thomasnisole/ESP32-Evo-Remote-Pilot-NMEA2000/KiCAD/ESP32EvoPilotRemote/ESP32EvoPilotRemote.kicad_pcb

## KiCad design KiCAD/ESP32EvoPilotRemote/ESP32EvoPilotRemote.kicad_pcb (2023-03-05)

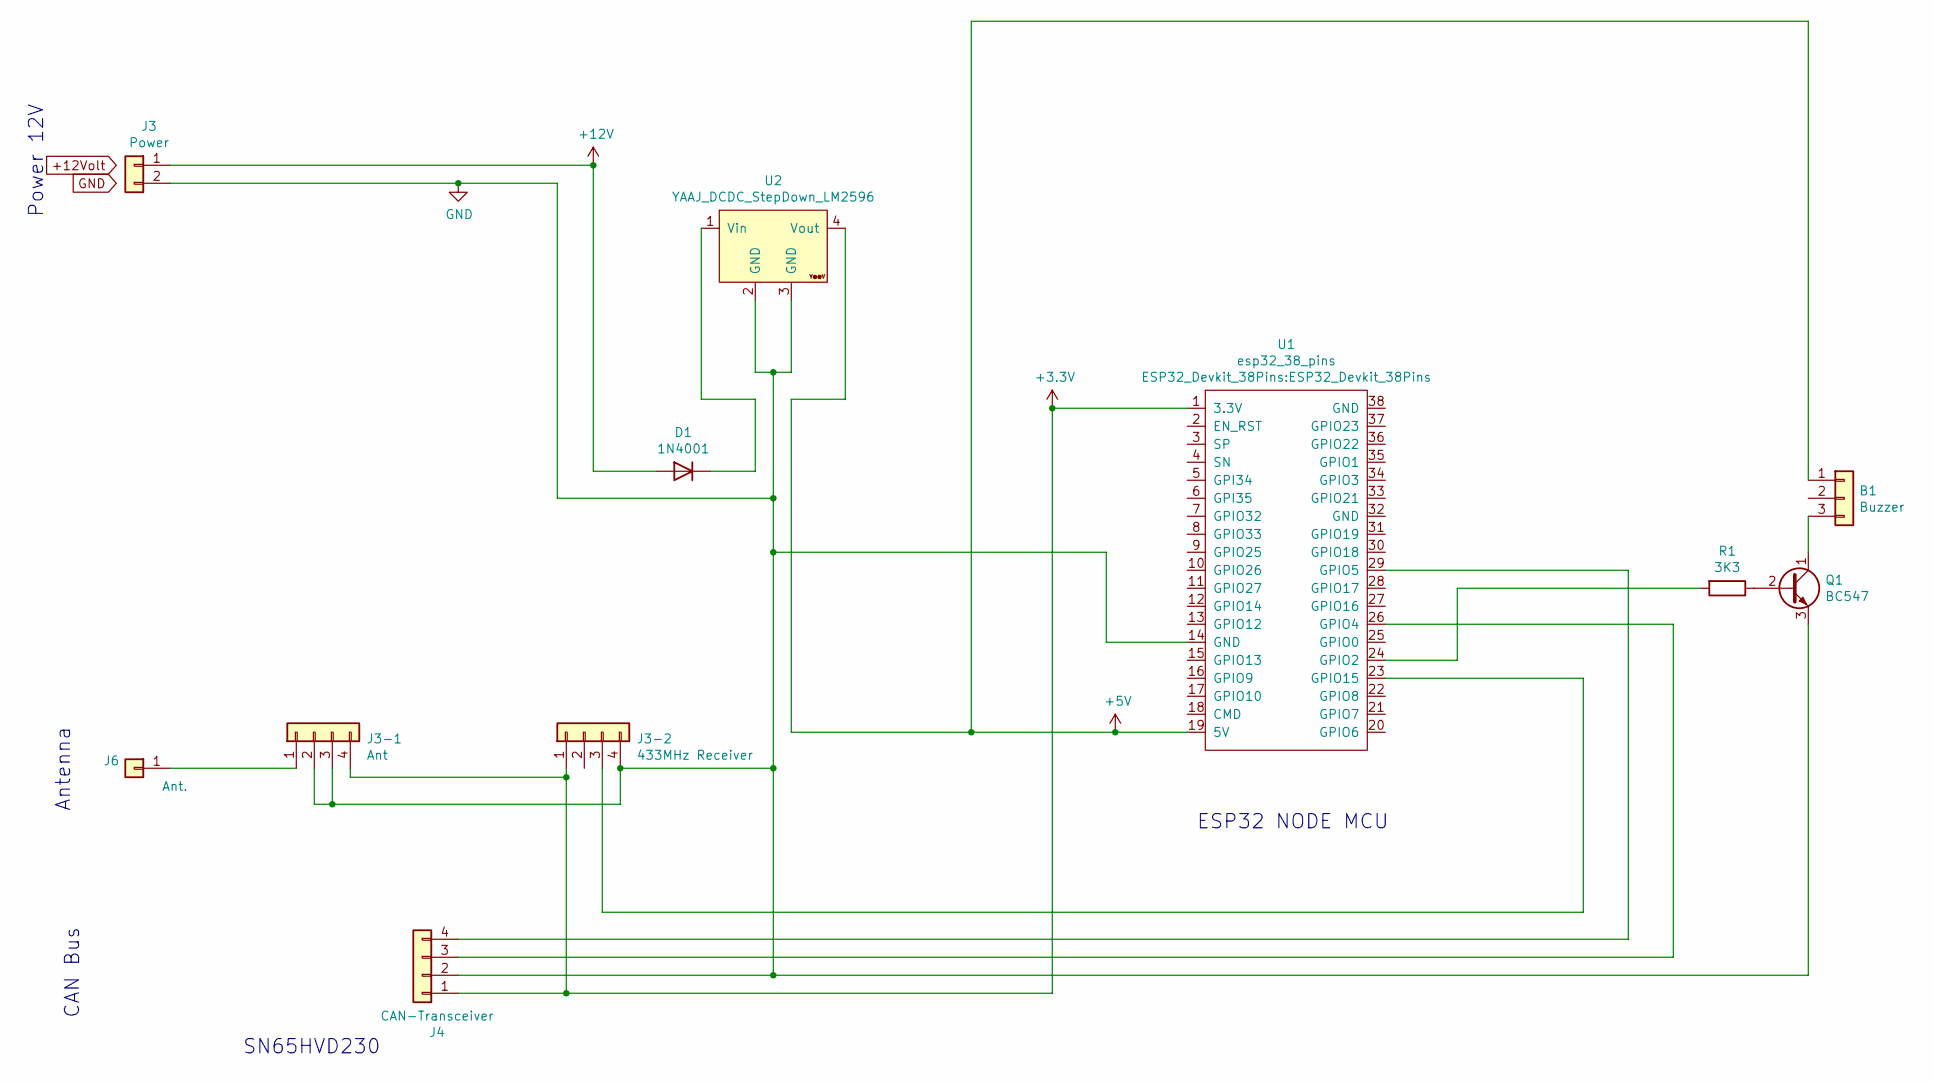
[picture p1: schematic ESP32EvoPilotRemote.sch]

Parts:
B1: Buzzer; PinHeader_1x03_P2.54mm_Vertical
D1: 1N4001; D_DO-41_SOD81_P10.16mm_Horizontal
J3: Power; TerminalBlock_bornier-2_P5.08mm
J3-1: Ant; PinHeader_1x04_P2.54mm_Vertical
J3-2: 433MHz Receiver; PinHeader_1x04_P2.54mm_Vertical
J4: CAN-Transceiver; PinHeader_1x04_P2.54mm_Vertical
J6: Ant.; Pin_D1.0mm_L10.0mm
Q1: BC547; TO-92_HandSolder
R1: 3K3; R_Axial_DIN0207_L6.3mm_D2.5mm_P10.16mm_Horizontal
U1: esp32_38_pins; ESP32_Devkit_38Pins
U2: YAAJ_DCDC_StepDown_LM2596

Connections:
+3V3: J3-1.4, J3-2.1, J4.1, U1.1 (3.3V)
+5V: B1.1, U1.19 (5V), U2.4 (Vout)
+12V: D1.2 (A), J3.1
GND: J3.2, J3-1.2, J3-1.3, J3-2.4, J4.2, Q1.3 (E), U1.14 (GND), U2.2 (GND), U2.3 (GND)
unnamed: B1.3, Q1.1 (C)
unnamed: D1.1 (K), U2.1 (Vin)
unnamed: J3-1.1, J6.1
unnamed: J3-2.3, U1.23 (GPIO15)
unnamed: J4.3, U1.26 (GPIO4)
unnamed: J4.4, U1.29 (GPIO5)
unnamed: Q1.2 (B), R1.1
unnamed: R1.2, U1.24 (GPIO2)

Notes on the sheet:
ESP32 NODE MCU
SN65HVD230
CAN Bus
Power 12V
Antenna

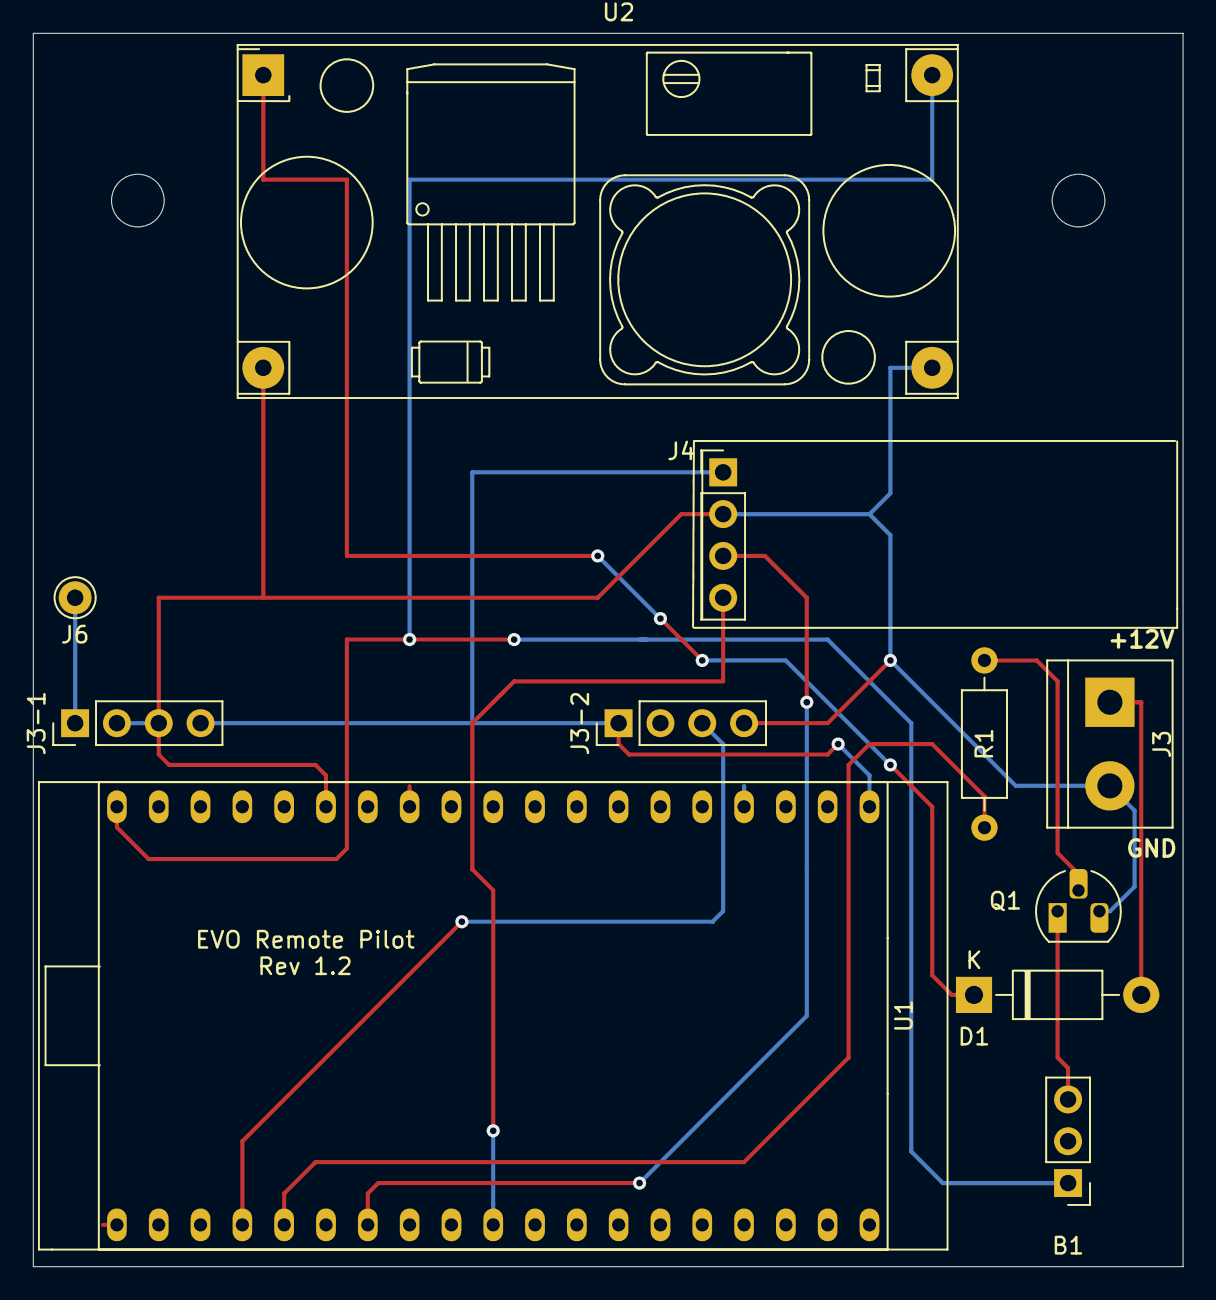
[picture p2: board ESP32EvoPilotRemote.kicad_pcb from above]

Board: 2 copper layers, 69.8 x 74.9 mm, 13 parts (0 on the bottom side), 12 nets.

Other parts of the board:
 : MountingHole_3.2mm_M3
 #2: MountingHole_3.2mm_M3
