thomasnisole/ESP32-Evo-Remote-Pilot-NMEA2000/(commit log)

2022-04-29 feat: Configure pin
2023-03-05 feat: Update KiCAD and ino
    [ESP32EvoPilotRemote-B_Cu.gbr, ESP32EvoPilotRemote-B_Mask.gbr, ESP32EvoPilotRemote-B_Paste.gbr, ESP32EvoPilotRemote-B_SilkS.gbr, ESP32EvoPilotRemote-Edge_Cuts.gbr, ESP32EvoPilotRemote-F_Cu.gbr, ESP32EvoPilotRemote-F_Mask.gbr, ESP32EvoPilotRemote-F_Paste.gbr]
